cyberjunkiefr/capteur-niveau-cuve-micropython-picoweb/documents/pictures/5.jpg

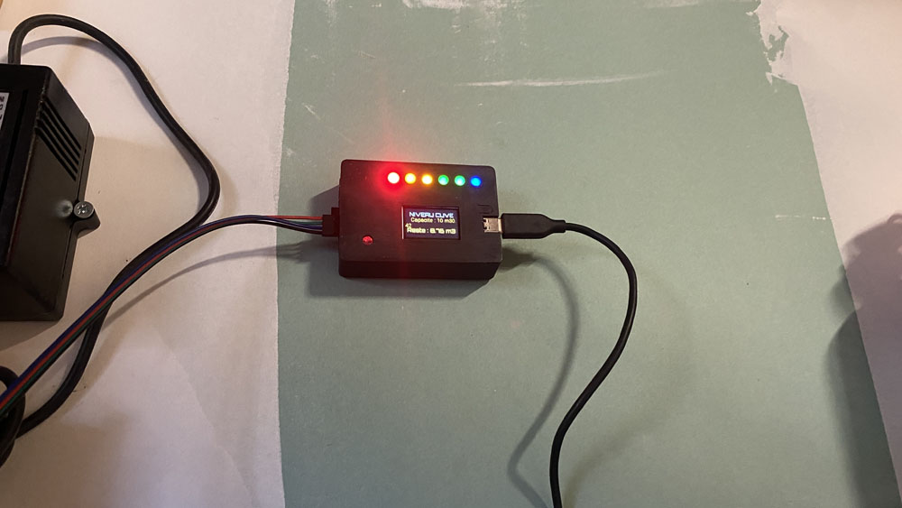
documents/pictures/5.jpg
