cyberjunkiefr/capteur-niveau-cuve-micropython-picoweb/documents/pictures/1.jpg

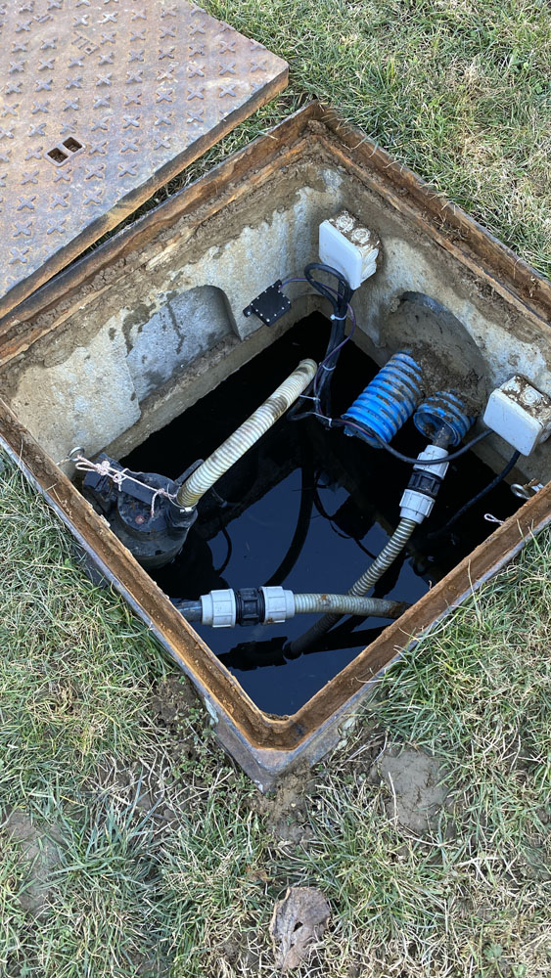
documents/pictures/1.jpg
