cyberjunkiefr/capteur-niveau-cuve-micropython-picoweb/documents/pictures/2.jpg

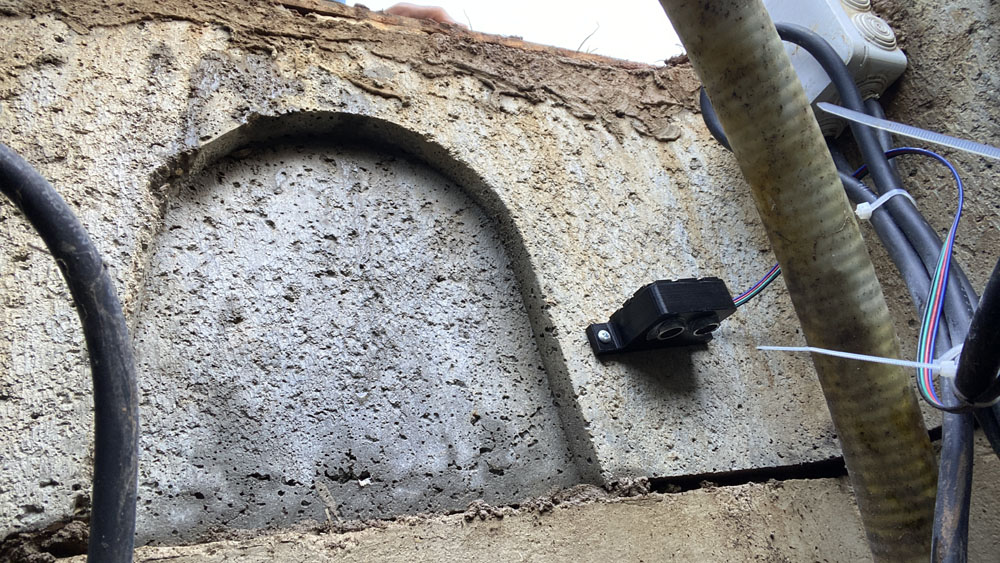
documents/pictures/2.jpg
