cyberjunkiefr/capteur-niveau-cuve-micropython-picoweb/documents/pictures/3.jpg

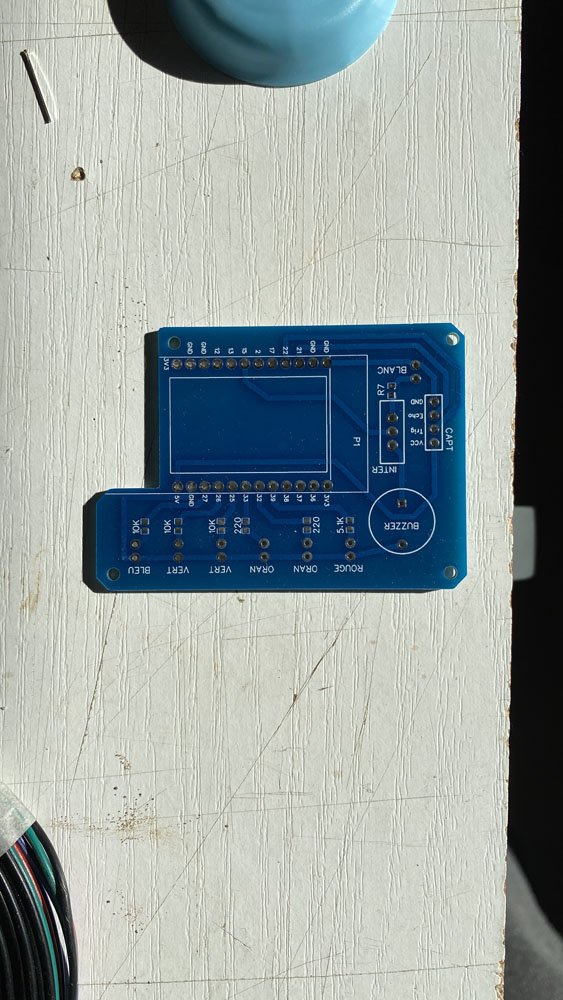
documents/pictures/3.jpg
