cyberjunkiefr/capteur-niveau-cuve-micropython-picoweb/documents/pictures/4.jpg

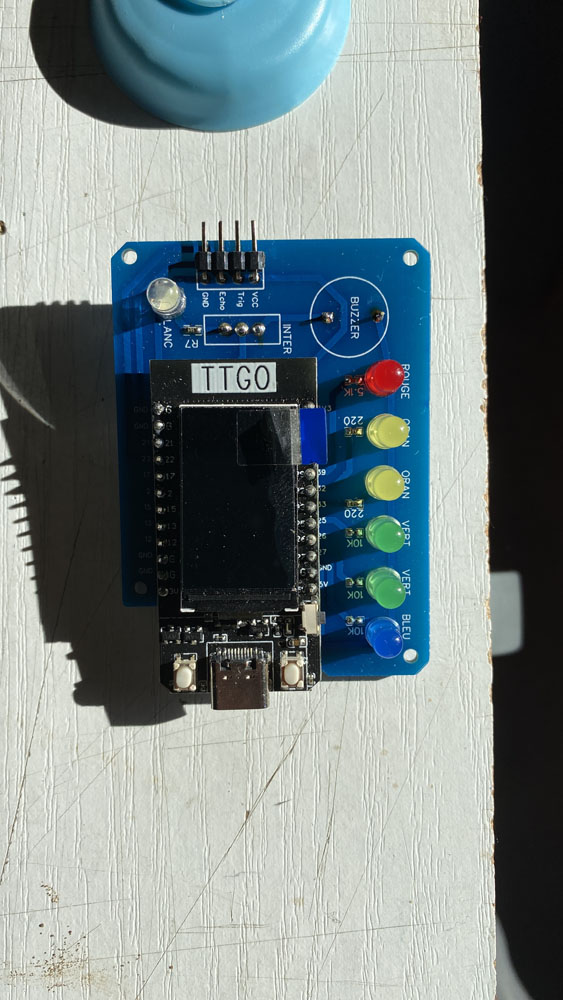
documents/pictures/4.jpg
