cyberjunkiefr/capteur-niveau-cuve-micropython-picoweb/web/goutte_eau.jpg

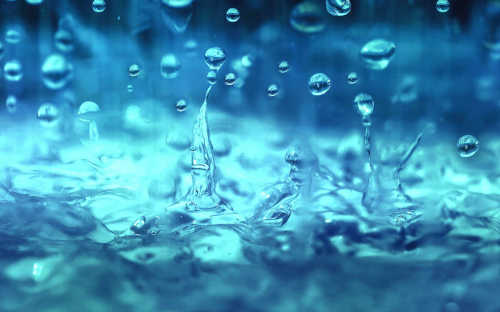
web/goutte_eau.jpg
