cyberjunkiefr/capteur-niveau-cuve-micropython-picoweb/documents/BOM_PCB_niveau_cuve_2022-02-23.pdf

## CAPTEUR NIVEAU D'EAU CUVE

Name | Designator | Footprint | Quantity
LED-TH-5mm_White (https://fr.aliexpress.com/item/1005002373439800.html) | LED3 | LED-TH_BD5.0_GREEN | 1
LED-TH-5mm_Blue (https://fr.aliexpress.com/item/1005002373439800.html) | LED7 | LED-TH_BD5.0_BLUE | 1
LED-TH-5mm_Red (https://fr.aliexpress.com/item/1005002373439800.html) | LED2 | LED-TH_BD5.0_RED | 1
LED-TH-5mm_Yellow (https://fr.aliexpress.com/item/1005002373439800.html) | LED4,LED5 | LED-TH_BD5.0_RED | 2
LED-TH-5mm_Green (https://fr.aliexpress.com/item/1005002373439800.html) | LED6,LED1 | LED-TH_BD5.0_GREEN | 2
SWITCH 2 positions (https://fr.aliexpress.com/item/32765155281.html?pdp_ext_f=%7B%22sku_id%22%3A%2262164596266%22%7D) | S2 | SWITCH-SPDT | 1
5k RESISTOR (https://www.amazon.fr/ARCELI-dassortiment-r%C3%A9sistances-r%C3%A9sistance-Chaque/dp/B07RTH6JHX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) | R1,R2 | R0805 | 2
10k RESISTOR (https://www.amazon.fr/ARCELI-dassortiment-r%C3%A9sistances-r%C3%A9sistance-Chaque/dp/B07RTH6JHX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) | R6,R3,R4,R5,R8 (https://www.amazon.fr/ARCELI-dassortiment-r%C3%A9sistances-r%C3%A9sistance-Chaque/dp/B07RTH6JHX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) | R0805 (https://www.amazon.fr/ARCELI-dassortiment-r%C3%A9sistances-r%C3%A9sistance-Chaque/dp/B07RTH6JHX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) | 5 (https://www.amazon.fr/ARCELI-dassortiment-r%C3%A9sistances-r%C3%A9sistance-Chaque/dp/B07RTH6JHX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)
HCSR04 (https://www.amazon.fr/AZDelivery-Capteur-ultrasons-T%C3%A9l%C3%A9m%C3%A8tre-Raspberry/dp/B07TKVPPHF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) | H1 | 20201128 SMA HCSR04 | 1
Buzzer (https://fr.aliexpress.com/item/1005003022264282.html) | U2 | BUZZER | 1
ESP32-TTGO-T-Display-V1.0 (https://fr.aliexpress.com/item/33050667207.html) | P1 | ESP32-2X12-TTGO-TDISPLAY | 1
