cyberjunkiefr/capteur-niveau-cuve-micropython-picoweb/documents/STL/niveau_eau_boitier_v2.stl

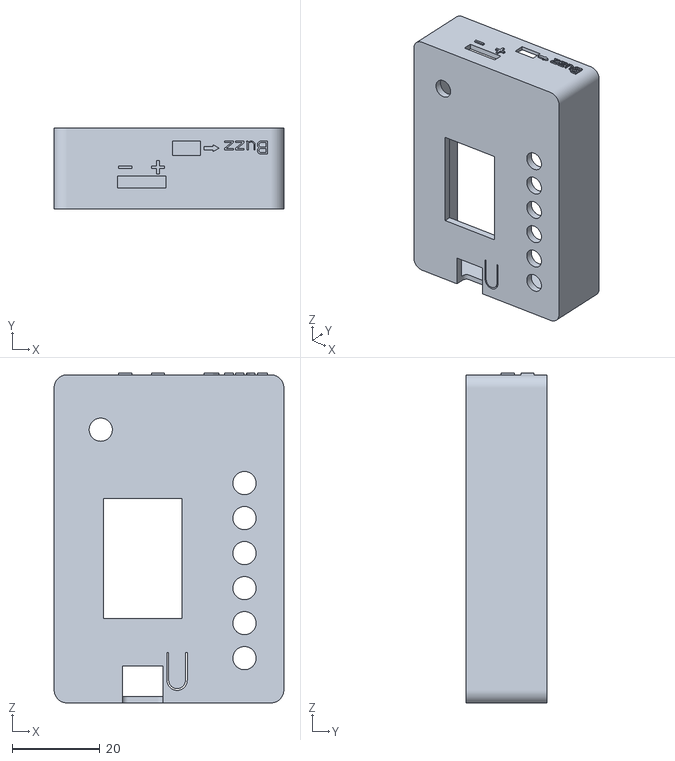
[picture p7: CAD file, 2022-05-22]
documents/STL/niveau_eau_boitier_v2.stl
52.5 x 18.6 x 75.4
