cyberjunkiefr/capteur-niveau-cuve-micropython-picoweb/documents/STL/boitier_hcsr04.stl

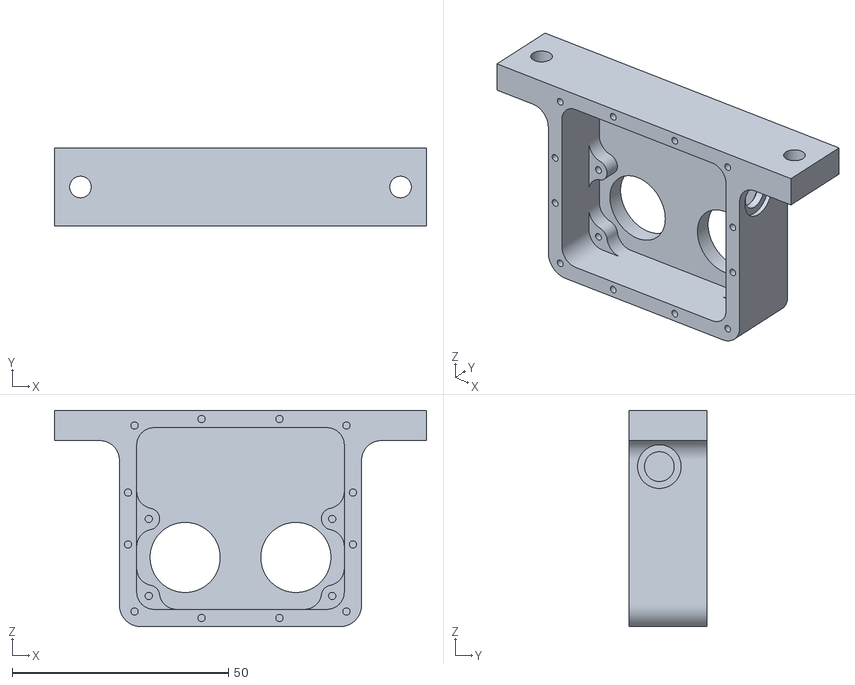
[picture p8: CAD file, 2022-05-22]
documents/STL/boitier_hcsr04.stl
86.0 x 18.0 x 50.0
