cyberjunkiefr/capteur-niveau-cuve-micropython-picoweb/documents/STL/fond_boitier_hcsr04.stl

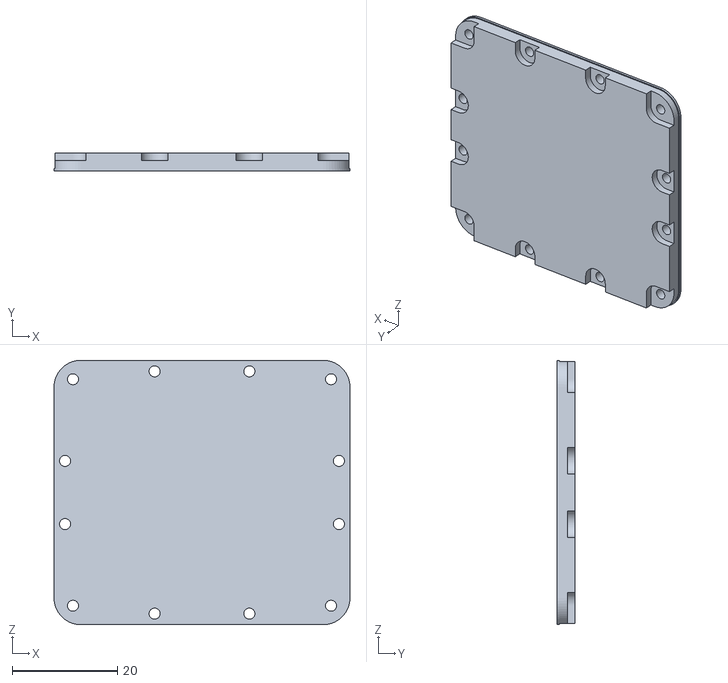
[picture p9: CAD file, 2022-05-22]
documents/STL/fond_boitier_hcsr04.stl
56.2 x 3.50 x 50.2
