cyberjunkiefr/capteur-niveau-cuve-micropython-picoweb/documents/STL/niveau_eau_pied.stl

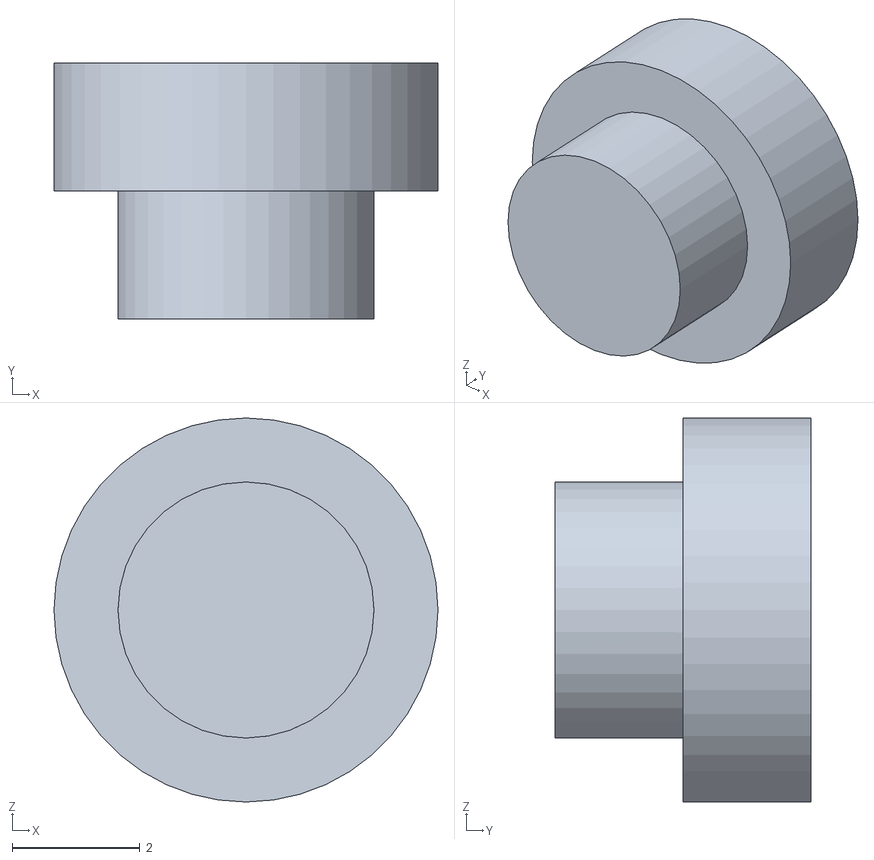
[picture p10: CAD file, 2022-05-22]
documents/STL/niveau_eau_pied.stl
6.00 x 4.00 x 6.00
