cyberjunkiefr/capteur-niveau-cuve-micropython-picoweb/documents/STL/niveau_eau_fond_v2.stl

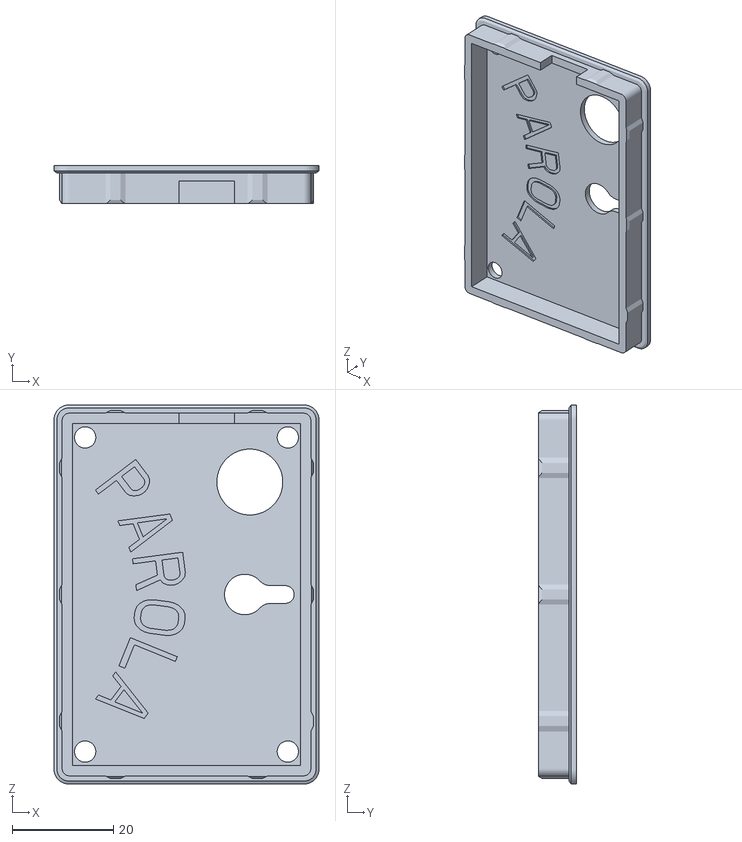
[picture p11: CAD file, 2022-05-22]
documents/STL/niveau_eau_fond_v2.stl
52.3 x 7.50 x 74.8
