cyberjunkiefr/capteur-niveau-cuve-micropython-picoweb/documents/Schematic_niveau_cuve_2022-02-23.pdf

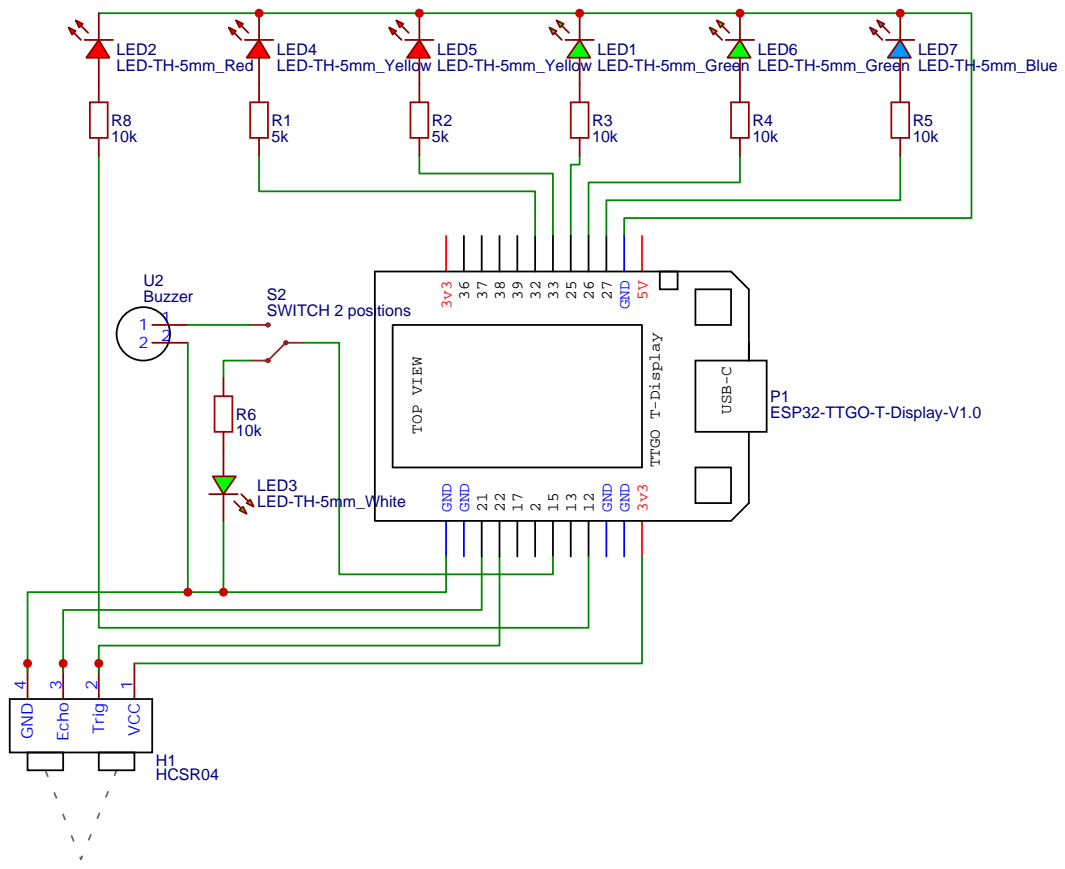
[picture p12: page 1]

Company: Acrofly Val de Morteau
