cyberjunkiefr/capteur-niveau-cuve-micropython-picoweb/documents/PCB_PCB_niveau_cuve_2022-02-23.pdf

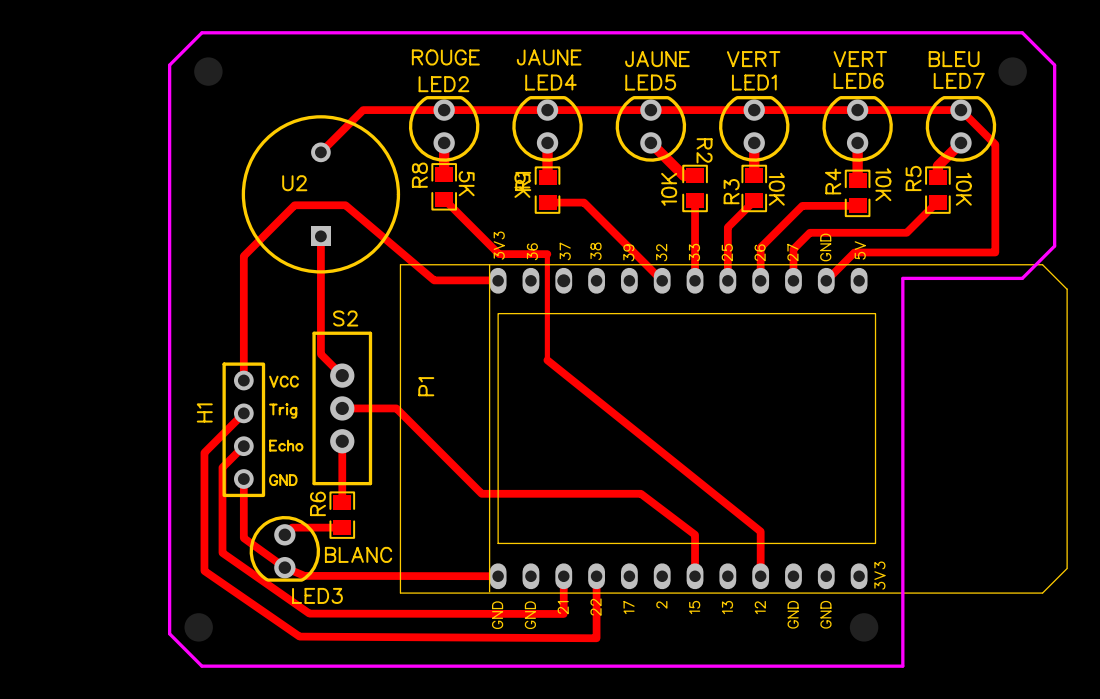
[picture p13: page 1]
