cyberjunkiefr/capteur-niveau-cuve-micropython-picoweb/(commit log)

2022-03-15 retrait ssid et passeword perso
    retrait ssid et passeword perso, retrait de la valeur fixe du capteur pour essai
    [main.py]
2022-03-17 main fonctionnel picoweb
    programme fonctionnel avec handleInterrupt toute les minutes et retour donnée sur page web
2022-03-23 modif html, background et cache-content ok
    style de la balise body dans le fichier html et font-size de la balise à 0px pour cacher le cache-content
2022-04-01 main simplifié, corrigé, mesures multiples
    correction des petites erreurs de syntaxe, ajout d'une mesure multiple pour plus de précision dans la valeur affichée. Correction de l'affichage lors des erreurs de mesure.
    [main.py]
2022-04-09 ajout des documents, firmware, pictures, STL files and PCB files
    [BOM_PCB_niveau_cuve_2022-02-23.xlsx, niveau_eau_boitier_v2.stl, niveau_eau_fond_v2.stl, niveau_eau_pied.stl]
2022-04-09 add STL files HCSR-04
    [boitier_hcsr04.stl, fond_boitier_hcsr04.stl]
2022-05-20 Amelioration, led en PWM, extinction de l'écran par appui bouton, separation affichage digit et num
    ajout des Output en PWM, diminution de la fréquence
    extinction de l'écran et allumage à la demande par appui sur le bouton poussoir PIN 35
    prise de mesure plus rapide pour diminuer le tps d'attente
    séparation de l'affichage numérique et digital
